cmichailidis/Guitar-Pedal/jlcpcb/production_files/BOM-guitar_pedal.csv

Comment | Designator | Footprint | LCSC | Quantity
4.7R | R40 | R_Axial_DIN0207_L6.3mm_D2.5mm_P7.62mm_Horizontal |  | 1
47n | C21 | C_Rect_L7.2mm_W2.5mm_P5.00mm_FKS2_FKP2_MKS2_MKP2 |  | 1
2.2k | R19 | R_Axial_DIN0207_L6.3mm_D2.5mm_P7.62mm_Horizontal |  | 1
470n | C17 | C_Rect_L7.2mm_W3.5mm_P5.00mm_FKS2_FKP2_MKS2_MKP2 |  | 1
100p | C16 | C_Disc_D6.0mm_W2.5mm_P5.00mm |  | 1
470k | R11 | R_Axial_DIN0207_L6.3mm_D2.5mm_P7.62mm_Horizontal |  | 1
470k | R37 | R_Axial_DIN0207_L6.3mm_D2.5mm_P7.62mm_Horizontal |  | 1
2N3904 | Q1 | TO-92_Inline |  | 1
1N4148 | D6 | D_DO-35_SOD27_P7.62mm_Horizontal |  | 1
100n | C6 | C_Rect_L7.2mm_W2.5mm_P5.00mm_FKS2_FKP2_MKS2_MKP2 |  | 1
2.2k | R41 | R_Axial_DIN0207_L6.3mm_D2.5mm_P7.62mm_Horizontal |  | 1
10k | R32 | R_Axial_DIN0207_L6.3mm_D2.5mm_P7.62mm_Horizontal |  | 1
470k | R35 | R_Axial_DIN0207_L6.3mm_D2.5mm_P7.62mm_Horizontal |  | 1
470n | C18 | C_Rect_L7.2mm_W3.5mm_P5.00mm_FKS2_FKP2_MKS2_MKP2 |  | 1
8.2k | R31 | R_Axial_DIN0207_L6.3mm_D2.5mm_P7.62mm_Horizontal |  | 1
2.2k | R43 | R_Axial_DIN0207_L6.3mm_D2.5mm_P7.62mm_Horizontal |  | 1
470n | C11 | C_Rect_L7.2mm_W3.5mm_P5.00mm_FKS2_FKP2_MKS2_MKP2 |  | 1
1M | R6 | R_Axial_DIN0207_L6.3mm_D2.5mm_P7.62mm_Horizontal |  | 1
2N3904 | Q5 | TO-92_Inline |  | 1
1k | R24 | R_Axial_DIN0207_L6.3mm_D2.5mm_P7.62mm_Horizontal |  | 1
Conn_01x02_Pin | J1 | PinHeader_1x02_P2.54mm_Vertical |  | 1
47n | C8 | C_Rect_L7.2mm_W2.5mm_P5.00mm_FKS2_FKP2_MKS2_MKP2 |  | 1
47u | C2 | CP_Radial_D6.3mm_P2.50mm |  | 1
2N3904 | Q3 | TO-92_Inline |  | 1
470k | R23 | R_Axial_DIN0207_L6.3mm_D2.5mm_P7.62mm_Horizontal |  | 1
4.7M | R33 | R_Axial_DIN0207_L6.3mm_D2.5mm_P7.62mm_Horizontal |  | 1
1k | R4 | R_Axial_DIN0207_L6.3mm_D2.5mm_P7.62mm_Horizontal |  | 1
100R | R36 | R_Axial_DIN0207_L6.3mm_D2.5mm_P7.62mm_Horizontal |  | 1
100k | R48 | R_Axial_DIN0207_L6.3mm_D2.5mm_P7.62mm_Horizontal |  | 1
22k | R46 | R_Axial_DIN0207_L6.3mm_D2.5mm_P7.62mm_Horizontal |  | 1
250p | C13 | C_Disc_D6.0mm_W2.5mm_P5.00mm |  | 1
10p | C26 | C_Disc_D6.0mm_W2.5mm_P5.00mm |  | 1
100n | C5 | C_Rect_L7.2mm_W2.5mm_P5.00mm_FKS2_FKP2_MKS2_MKP2 |  | 1
220p | C7 | C_Disc_D6.0mm_W2.5mm_P5.00mm |  | 1
47k | R15 | R_Axial_DIN0207_L6.3mm_D2.5mm_P7.62mm_Horizontal |  | 1
1N4148 | D1 | D_DO-35_SOD27_P7.62mm_Horizontal |  | 1
10k | R38 | R_Axial_DIN0207_L6.3mm_D2.5mm_P7.62mm_Horizontal |  | 1
10k | R25 | R_Axial_DIN0207_L6.3mm_D2.5mm_P7.62mm_Horizontal |  | 1
100k | R49 | R_Axial_DIN0207_L6.3mm_D2.5mm_P7.62mm_Horizontal |  | 1
100k | R16 | R_Axial_DIN0207_L6.3mm_D2.5mm_P7.62mm_Horizontal |  | 1
47n | C12 | C_Rect_L7.2mm_W2.5mm_P5.00mm_FKS2_FKP2_MKS2_MKP2 |  | 1
100k | RV4 | PinHeader_1x03_P2.54mm_Vertical |  | 1
4.7n | C30 | C_Rect_L7.2mm_W2.5mm_P5.00mm_FKS2_FKP2_MKS2_MKP2 |  | 1
470n | C24 | C_Rect_L7.2mm_W3.5mm_P5.00mm_FKS2_FKP2_MKS2_MKP2 |  | 1
100n | C10 | C_Rect_L7.2mm_W2.5mm_P5.00mm_FKS2_FKP2_MKS2_MKP2 |  | 1
10k | R1 | R_Axial_DIN0207_L6.3mm_D2.5mm_P7.62mm_Horizontal |  | 1
10u | C31 | C_Disc_D6.0mm_W2.5mm_P5.00mm |  | 1
LM358 | U4 | DIP-8_W7.62mm |  | 1
1N5819 | D9 | D_DO-41_SOD81_P10.16mm_Horizontal |  | 1
LM358 | U3 | DIP-8_W7.62mm |  | 1
1k | R28 | R_Axial_DIN0207_L6.3mm_D2.5mm_P7.62mm_Horizontal |  | 1
100n | C15 | C_Rect_L7.2mm_W2.5mm_P5.00mm_FKS2_FKP2_MKS2_MKP2 |  | 1
15n | C20 | C_Rect_L7.2mm_W2.5mm_P5.00mm_FKS2_FKP2_MKS2_MKP2 |  | 1
1N4148 | D4 | D_DO-35_SOD27_P7.62mm_Horizontal |  | 1
10k | R2 | R_Axial_DIN0207_L6.3mm_D2.5mm_P7.62mm_Horizontal |  | 1
LM358 | U2 | DIP-8_W7.62mm |  | 1
47n | C28 | C_Rect_L7.2mm_W2.5mm_P5.00mm_FKS2_FKP2_MKS2_MKP2 |  | 1
47k | R34 | R_Axial_DIN0207_L6.3mm_D2.5mm_P7.62mm_Horizontal |  | 1
10k | R27 | R_Axial_DIN0207_L6.3mm_D2.5mm_P7.62mm_Horizontal |  | 1
2.2k | R18 | R_Axial_DIN0207_L6.3mm_D2.5mm_P7.62mm_Horizontal |  | 1
10k | R12 | R_Axial_DIN0207_L6.3mm_D2.5mm_P7.62mm_Horizontal |  | 1
100k | R39 | R_Axial_DIN0207_L6.3mm_D2.5mm_P7.62mm_Horizontal |  | 1
1k | R7 | R_Axial_DIN0207_L6.3mm_D2.5mm_P7.62mm_Horizontal |  | 1
100k | R9 | R_Axial_DIN0207_L6.3mm_D2.5mm_P7.62mm_Horizontal |  | 1
22k | RV2 | PinHeader_1x03_P2.54mm_Vertical |  | 1
100k | RV1 | PinHeader_1x03_P2.54mm_Vertical |  | 1
10k | R29 | R_Axial_DIN0207_L6.3mm_D2.5mm_P7.62mm_Horizontal |  | 1
Conn_01x02_Pin | J3 | PinHeader_1x02_P2.54mm_Vertical |  | 1
4.7u | C27 | CP_Radial_D5.0mm_P2.50mm |  | 1
1N4148 | D8 | D_DO-35_SOD27_P7.62mm_Horizontal |  | 1
10k | R21 | R_Axial_DIN0207_L6.3mm_D2.5mm_P7.62mm_Horizontal |  | 1
470k | R8 | R_Axial_DIN0207_L6.3mm_D2.5mm_P7.62mm_Horizontal |  | 1
LM358 | U1 | DIP-8_W7.62mm |  | 1
10k | R22 | R_Axial_DIN0207_L6.3mm_D2.5mm_P7.62mm_Horizontal |  | 1
470n | C23 | C_Rect_L7.2mm_W3.5mm_P5.00mm_FKS2_FKP2_MKS2_MKP2 |  | 1
100k | RV5 | PinHeader_1x03_P2.54mm_Vertical |  | 1
1N4148 | D5 | D_DO-35_SOD27_P7.62mm_Horizontal |  | 1
56k | R26 | R_Axial_DIN0207_L6.3mm_D2.5mm_P7.62mm_Horizontal |  | 1
100k | R42 | R_Axial_DIN0207_L6.3mm_D2.5mm_P7.62mm_Horizontal |  | 1
10k | R20 | R_Axial_DIN0207_L6.3mm_D2.5mm_P7.62mm_Horizontal |  | 1
4.7k | R17 | R_Axial_DIN0207_L6.3mm_D2.5mm_P7.62mm_Horizontal |  | 1
100n | C25 | C_Rect_L7.2mm_W2.5mm_P5.00mm_FKS2_FKP2_MKS2_MKP2 |  | 1
1N4148 | D3 | D_DO-35_SOD27_P7.62mm_Horizontal |  | 1
Conn_01x02_Pin | J2 | PinHeader_1x02_P2.54mm_Vertical |  | 1
2.2k | R47 | R_Axial_DIN0207_L6.3mm_D2.5mm_P7.62mm_Horizontal |  | 1
100n | C29 | C_Rect_L7.2mm_W2.5mm_P5.00mm_FKS2_FKP2_MKS2_MKP2 |  | 1
100k | RV3 | PinHeader_1x03_P2.54mm_Vertical |  | 1
100k | R10 | R_Axial_DIN0207_L6.3mm_D2.5mm_P7.62mm_Horizontal |  | 1
2N3904 | Q4 | TO-92_Inline |  | 1
LM358 | U5 | DIP-8_W7.62mm |  | 1
2.2k | R45 | R_Axial_DIN0207_L6.3mm_D2.5mm_P7.62mm_Horizontal |  | 1
47n | C9 | C_Rect_L7.2mm_W2.5mm_P5.00mm_FKS2_FKP2_MKS2_MKP2 |  | 1
4.7M | R5 | R_Axial_DIN0207_L6.3mm_D2.5mm_P7.62mm_Horizontal |  | 1
4.7n | C19 | C_Rect_L7.2mm_W2.5mm_P5.00mm_FKS2_FKP2_MKS2_MKP2 |  | 1
47u | C4 | CP_Radial_D6.3mm_P2.50mm |  | 1
22k | R44 | R_Axial_DIN0207_L6.3mm_D2.5mm_P7.62mm_Horizontal |  | 1
47n | C22 | C_Rect_L7.2mm_W2.5mm_P5.00mm_FKS2_FKP2_MKS2_MKP2 |  | 1
47k | R30 | R_Axial_DIN0207_L6.3mm_D2.5mm_P7.62mm_Horizontal |  | 1
68n | C14 | C_Rect_L7.2mm_W2.5mm_P5.00mm_FKS2_FKP2_MKS2_MKP2 |  | 1
1N4148 | D2 | D_DO-35_SOD27_P7.62mm_Horizontal |  | 1
1N4148 | D7 | D_DO-35_SOD27_P7.62mm_Horizontal |  | 1
10R | R3 | R_Axial_DIN0207_L6.3mm_D2.5mm_P7.62mm_Horizontal |  | 1
47u | C1 | CP_Radial_D6.3mm_P2.50mm |  | 1
100k | R14 | R_Axial_DIN0207_L6.3mm_D2.5mm_P7.62mm_Horizontal |  | 1
2N3904 | Q2 | TO-92_Inline |  | 1
100n | C3 | C_Rect_L7.2mm_W2.5mm_P5.00mm_FKS2_FKP2_MKS2_MKP2 |  | 1
22R | R13 | R_Axial_DIN0207_L6.3mm_D2.5mm_P7.62mm_Horizontal |  | 1
LED | LED3 | PinHeader_1x02_P2.54mm_Vertical |  | 1
Conn_01x02_Pin | J4 | PinHeader_1x02_P2.54mm_Vertical |  | 1
LED | LED1 | PinHeader_1x02_P2.54mm_Vertical |  | 1
LED | LED2 | PinHeader_1x02_P2.54mm_Vertical |  | 1
