cmichailidis/Guitar-Pedal/guitar_pedal.csv

????? | ???????? | ???? | ?????????
C1,C2,C4 | 5 | 47u | ???????? ?????????????? (??????????? 16V)
C3,C5,C6,C10,C15,C25,C29 | 10 | 100n | ???????? ?????????? (???)
C7 | 5 | 220p | ???????? ????????? (??????)
C8,C9,C12,C21,C22,C28 | 10 | 47n | ???????? ?????????? (???)
C11,C17,C18,C23,C24 | 10 | 470n | ???????? ?????????? (???)
C13 | 5 | 250p | ???????? ????????? (??????)
C14 | 5 | 68n | ???????? ?????????? (???)
C16 | 5 | 100p | ???????? ????????? (??????)
C19,C30 | 5 | 4.7n | ???????? ?????????? (???)
C20 | 5 | 15n | ???????? ?????????? (???)
C26 | 5 | 10p | ???????? ????????? (??????)
C27 | 5 | 4.7u | ???????? ?????????????? (??????????? 16V)
C31 | 5 | 10u | ???????? ?????????????? (??????????? 16V)
D1,D2,D3,D4,D5,D6,D7,D8 | 10 | 1N4148 | ??????
D9 | 5 | 1N5819 | ?????? Shottky
Q1,Q2,Q3,Q4,Q5 | 10 | 2N3904 | ?????????? ????????
R1,R2,R12,R20,R21,R22,R25,R27,R29,R32 | 10 | 10k | ????????? 1/4Watt
R3 | 10 | 10R | ????????? 1/4Watt
R4,R7,R24,R28,R38 | 10 | 1k | ????????? 1/4Watt
R5,R33 | 10 | 4.7M | ????????? 1/4Watt
R6 | 10 | 1M | ????????? 1/4Watt
R8,R11,R23,R37 | 10 | 470k | ????????? 1/4Watt
R9,R10,R14,R16,R39,R42,R48,R49 | 10 | 100k | ????????? 1/4Watt
R13 | 10 | 22R | ????????? 1/4Watt
R15,R30,R35 | 10 | 47k | ????????? 1/4Watt
R17,R34 | 10 | 4.7k | ????????? 1/4Watt
R18,R19,R41,R43,R45,R47 | 10 | 2.2k | ????????? 1/4Watt
R26 | 10 | 56k | ????????? 1/4Watt
R31 | 10 | 8.2k | ????????? 1/4Watt
R36 | 10 | 100R | ????????? 1/4Watt
R40 | 10 | 4.7R | ????????? 1/4Watt
R44,R46 | 10 | 22k | ????????? 1/4Watt
U1,U2,U3,U4,U5,U6 | 10 | LM358 | ?????????? ????????? (???????????? ??????? ?? ?????? DIP8)
