cmichailidis/Guitar-Pedal/guitar_pedal.pdf

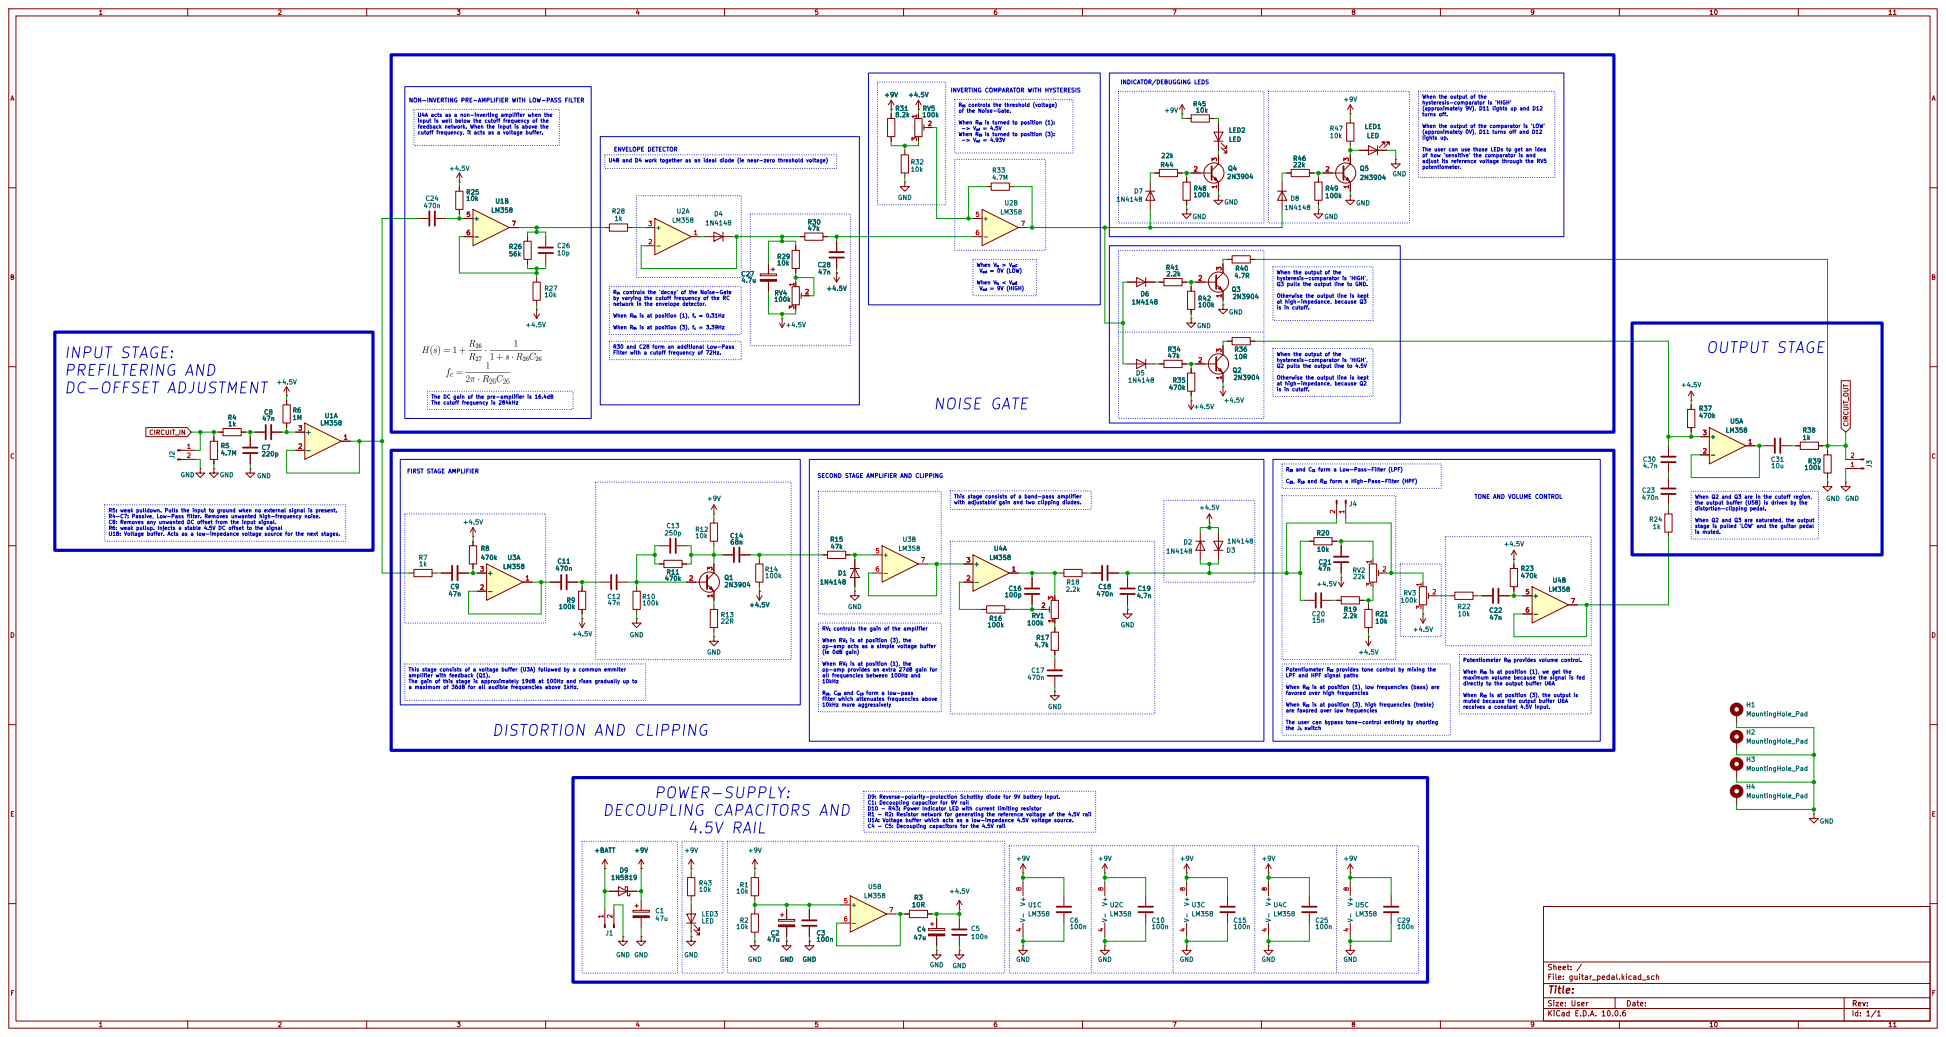
[picture p1: page 1]

INVERTING COMPARATOR WITH HYSTERESIS POWER-SUPPLY:

NON-INVERTING PRE-AMPLIFIER WITH LOW-PASS FILTER U1B

U4A acts as a non-inverting amplifier when the
input is well below the cutoff frequency of the
feedback network. When the input is above the

turns off. When the output of the comparator is 'LOW' (approximately 0V), D11 turns off and D12

lights up. The user can use those LEDs to get an idea

of how 'sensitive' the comparator is and
adjust its reference voltage through the RV5
potentiometer.

INPUT STAGE: PREFILTERING AND

The cutoff frequency is 284kHz

D9: Reverse-polarity-protection Schottky diode for 9V battery input. C1: Decoupling capacitor for 9V rail D10 - R43: Power Indicator LED with current limiting resistor R1 - R2: Resistor network for generating the reference voltage of the 4.5V rail U1A: Voltage buffer which acts as a low-impedance 4.5V voltage source. C4 - C5: Decoupling capacitors for the 4.5V rail NOISE GATE

is muted. R20 and C21 form a Low-Pass-Filter (LPF) C20, R19 and R21 form a High-Pass-Filter (HPF) RV1 controls the gain of the amplifier When RV1 is at position (3), the op-amp acts as a simple voltage buffer (ie 0dB gain) When RV1 is at position (1), the op-amp provides an extra 27dB gain for all frequencies between 100Hz and 10kHz R18, C18 and C19 form a low-pass
SECOND STAGE AMPLIFIER AND CLIPPING

TONE AND VOLUME CONTROL

This stage consists of a voltage buffer (U3A) followed by a common emmiter amplifier with feedback (Q1). The gain of this stage is approximately 19dB at 100Hz and rises gradually up to

LPF and HPF signal paths When RV2 is at position (1), low frequencies (bass) are

directly to the output buffer U6A When RV3 is at position (3), the output is muted because the output buffer U6A

favored over high frequencies When RV2 is at position (3), high frequencies (treble) are favored over low frequencies

filter which attenuates frequencies above 10kHz more aggressively

The user can bypass tone-control entirely by shorting
the J4 switch

Size: User | Rev:
KiCad E.D.A. 10.0.6 | Id: 1/1
