cmichailidis/Guitar-Pedal/guitar_pedal.kicad_pcb

## KiCad design guitar_pedal.kicad_pcb (2026-10-21)

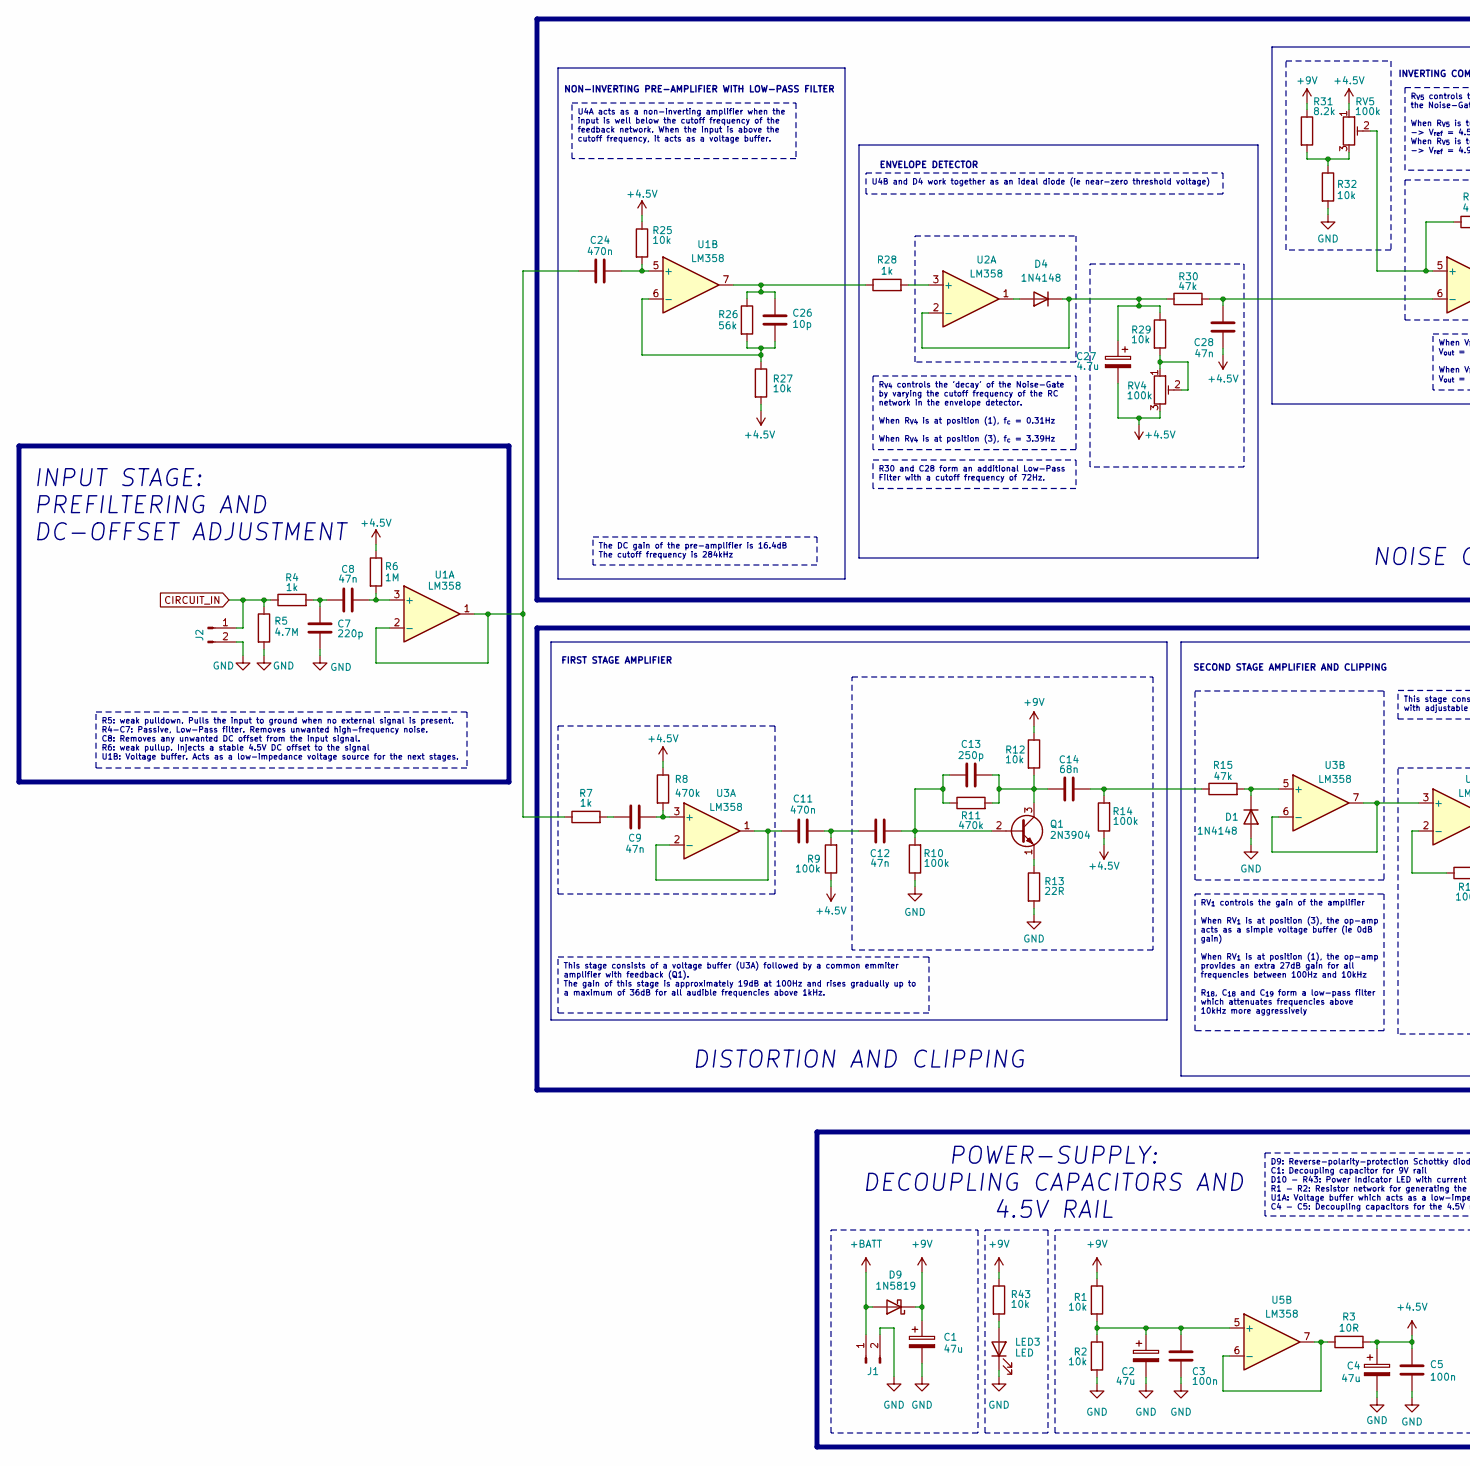
[picture p2: schematic guitar_pedal.kicad_sch, part in row 1, column 1]

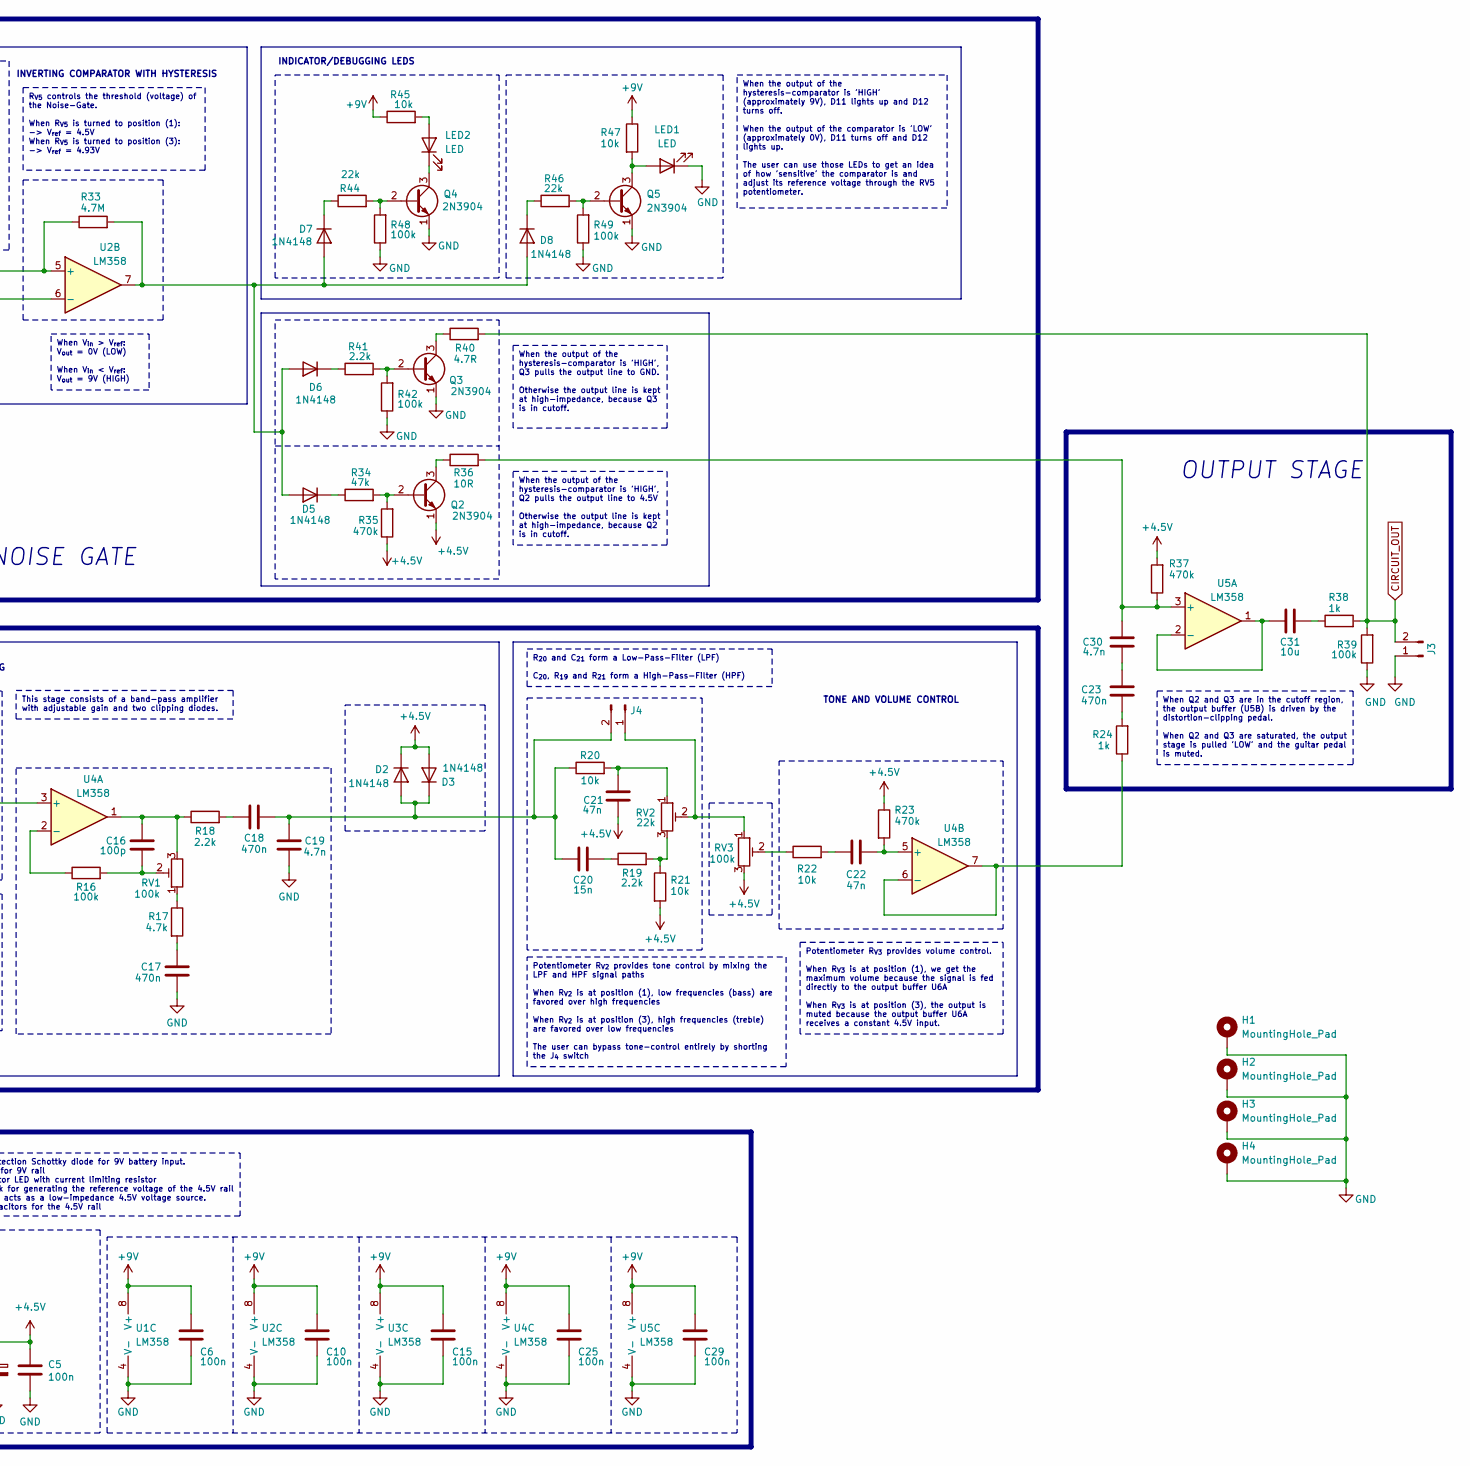
[picture p3: schematic guitar_pedal.kicad_sch, part in row 1, column 2]

Parts:
C1, C2, C4: 47u; CP_Radial_D6.3mm_P2.50mm
C3, C5, C6, C10, C15, C25, C29: 100n; C_Rect_L7.2mm_W2.5mm_P5.00mm_FKS2_FKP2_MKS2_MKP2
C7: 220p; C_Disc_D6.0mm_W2.5mm_P5.00mm
C8, C9, C12, C21, C22, C28: 47n; C_Rect_L7.2mm_W2.5mm_P5.00mm_FKS2_FKP2_MKS2_MKP2
C11, C17, C18, C23, C24: 470n; C_Rect_L7.2mm_W3.5mm_P5.00mm_FKS2_FKP2_MKS2_MKP2
C13: 250p; C_Disc_D6.0mm_W2.5mm_P5.00mm
C14: 68n; C_Rect_L7.2mm_W2.5mm_P5.00mm_FKS2_FKP2_MKS2_MKP2
C16: 100p; C_Disc_D6.0mm_W2.5mm_P5.00mm
C19, C30: 4.7n; C_Rect_L7.2mm_W2.5mm_P5.00mm_FKS2_FKP2_MKS2_MKP2
C20: 15n; C_Rect_L7.2mm_W2.5mm_P5.00mm_FKS2_FKP2_MKS2_MKP2
C26: 10p; C_Disc_D6.0mm_W2.5mm_P5.00mm
C27: 4.7u; CP_Radial_D5.0mm_P2.50mm
C31: 10u; C_Disc_D6.0mm_W2.5mm_P5.00mm
D1, D2, D3, D4, D5, D6, D7, D8: 1N4148; D_DO-35_SOD27_P7.62mm_Horizontal
D9: 1N5819; D_DO-41_SOD81_P10.16mm_Horizontal
H1, H2, H3, H4: MountingHole_Pad; MountingHole_3.2mm_M3_DIN965_Pad
J1, J2, J3, J4: Conn_01x02_Pin; PinHeader_1x02_P2.54mm_Vertical
LED1, LED2, LED3: LED; PinHeader_1x02_P2.54mm_Vertical
Q1, Q2, Q3, Q4, Q5: 2N3904; TO-92_Inline
R1, R2, R12, R20, R21, R22, R25, R27, R29, R32, R43, R45, R47: 10k; R_Axial_DIN0207_L6.3mm_D2.5mm_P7.62mm_Horizontal
R3, R36: 10R; R_Axial_DIN0207_L6.3mm_D2.5mm_P7.62mm_Horizontal
R4, R7, R24, R28, R38: 1k; R_Axial_DIN0207_L6.3mm_D2.5mm_P7.62mm_Horizontal
R5, R33: 4.7M; R_Axial_DIN0207_L6.3mm_D2.5mm_P7.62mm_Horizontal
R6: 1M; R_Axial_DIN0207_L6.3mm_D2.5mm_P7.62mm_Horizontal
R8, R11, R23, R35, R37: 470k; R_Axial_DIN0207_L6.3mm_D2.5mm_P7.62mm_Horizontal
R9, R10, R14, R16, R39, R42, R48, R49: 100k; R_Axial_DIN0207_L6.3mm_D2.5mm_P7.62mm_Horizontal
R13: 22R; R_Axial_DIN0207_L6.3mm_D2.5mm_P7.62mm_Horizontal
R15, R30, R34: 47k; R_Axial_DIN0207_L6.3mm_D2.5mm_P7.62mm_Horizontal
R17: 4.7k; R_Axial_DIN0207_L6.3mm_D2.5mm_P7.62mm_Horizontal
R18, R19, R41: 2.2k; R_Axial_DIN0207_L6.3mm_D2.5mm_P7.62mm_Horizontal
R26: 56k; R_Axial_DIN0207_L6.3mm_D2.5mm_P7.62mm_Horizontal
R31: 8.2k; R_Axial_DIN0207_L6.3mm_D2.5mm_P7.62mm_Horizontal
R40: 4.7R; R_Axial_DIN0207_L6.3mm_D2.5mm_P7.62mm_Horizontal
R44, R46: 22k; R_Axial_DIN0207_L6.3mm_D2.5mm_P7.62mm_Horizontal
RV1, RV3, RV4, RV5: 100k; PinHeader_1x03_P2.54mm_Vertical
RV2: 22k; PinHeader_1x03_P2.54mm_Vertical
U1, U2, U3, U4, U5: LM358; DIP-8_W7.62mm

Connections:
+4.5V: C4.1, C5.2, C21.1, C27.2, C28.1, D2.1 (K), D3.2 (A), Q2.1 (E), R3.2, R6.1, R8.1, R9.1, R14.1, R21.2, R23.1, R25.1, R27.2, R35.1, R37.2, RV3.3, RV4.3, RV5.1
+9V: C1.1, C6.2, C10.2, C15.2, C25.2, C29.2, D9.1 (K), R1.1, R12.1, R31.1, R43.1, R45.1, R47.1, U1.8 (V+), U2.8 (V+), U3.8 (V+), U4.8 (V+), U5.8 (V+)
+BATT: D9.2 (A), J1.1
CIRCUIT_IN: J2.1, R4.1, R5.1
CIRCUIT_OUT: J3.2, R38.2, R39.2, R40.2
GND: C1.2, C2.2, C3.1, C4.2, C5.1, C6.1, C7.1, C10.1, C15.1, C17.1, C19.1, C25.1, C29.1, D1.2 (A), H1.1 (1_1), H2.1 (1_1), H3.1 (1_1), H4.1 (1_1), J1.2, J2.2, J3.1, LED1.1 (K), LED3.1 (K), Q3.1 (E), Q4.1 (E), Q5.1 (E), R2.2, R5.2, R10.1, R13.2, R32.2, R39.1, R42.1, R48.1, R49.1, U1.4 (V-), U2.4 (V-), U3.4 (V-), U4.4 (V-), U5.4 (V-)
unnamed: C7.2, C8.1, R4.2
unnamed: C9.1, R7.2
unnamed: C11.2, C12.2, R9.2
unnamed: C14.2, R14.2, R15.1
unnamed: C16.1, R16.2, RV1.2
unnamed: C16.2, R18.1, RV1.3, U4.1
unnamed: C17.2, R17.2
unnamed: C18.1, R18.2
unnamed: C20.2, R19.1
unnamed: C21.2, R20.2, RV2.1
unnamed: C22.1, R22.2
unnamed: C23.1, R24.2
unnamed: C23.2, C30.1
unnamed: C26.2, R26.1, R28.1, U1.7
unnamed: C31.2, R38.1
unnamed: D1.1 (K), R15.2, U3.5 (+)
unnamed: C18.2, C19.2, C20.1, D2.2 (A), D3.1 (K), J4.2, R20.1
unnamed: D4.2 (A), U2.1
unnamed: C27.1, D4.1 (K), R29.1, R30.1, U2.2 (-)
unnamed: D5.2 (A), D6.2 (A), D7.2 (A), D8.2 (A), R33.2, U2.7
unnamed: D5.1 (K), R34.1
unnamed: D6.1 (K), R41.1
unnamed: D7.1 (K), R44.1
unnamed: D8.1 (K), R46.1
unnamed: J4.1, RV2.2, RV3.1
unnamed: LED1.2 (A), Q5.3 (C), R47.2
unnamed: LED2.2 (A), R45.2
unnamed: LED2.1 (K), Q4.3 (C)
unnamed: LED3.2 (A), R43.2
unnamed: C12.1, C13.1, Q1.2 (B), R10.2, R11.1
unnamed: C13.2, C14.1, Q1.3 (C), R11.2, R12.2
unnamed: Q1.1 (E), R13.1
unnamed: Q2.2 (B), R34.2, R35.2
unnamed: Q2.3 (C), R36.1
unnamed: Q3.2 (B), R41.2, R42.2
unnamed: Q3.3 (C), R40.1
unnamed: Q4.2 (B), R44.2, R48.2
unnamed: Q5.2 (B), R46.2, R49.2
unnamed: R17.1, RV1.1
unnamed: R19.2, R21.1, RV2.3
unnamed: R22.1, RV3.2
unnamed: R29.2, RV4.1, RV4.2
unnamed: R31.2, R32.1, RV5.3
unnamed: C8.2, R6.2, U1.3 (+)
unnamed: C24.1, R7.1, U1.1, U1.2 (-)
unnamed: C24.2, R25.2, U1.5 (+)
unnamed: C26.1, R26.2, R27.1, U1.6 (-)
unnamed: R28.2, U2.3 (+)
unnamed: R33.1, RV5.2, U2.5 (+)
unnamed: C28.2, R30.2, U2.6 (-)
unnamed: C9.2, R8.2, U3.3 (+)
unnamed: C11.1, U3.1, U3.2 (-)
unnamed: U3.6 (-), U3.7, U4.3 (+)
unnamed: R16.1, U4.2 (-)
unnamed: C22.2, R23.2, U4.5 (+)
unnamed: R24.1, U4.6 (-), U4.7
unnamed: C30.2, R36.2, R37.1, U5.3 (+)
unnamed: C31.1, U5.1, U5.2 (-)
unnamed: C2.1, C3.2, R1.2, R2.1, U5.5 (+)
unnamed: R3.1, U5.6 (-), U5.7

Notes on the sheet:
SECOND STAGE AMPLIFIER AND CLIPPING
POWER-SUPPLY: DECOUPLING CAPACITORS AND 4.5V RAIL
INPUT STAGE: PREFILTERING AND DC-OFFSET ADJUSTMENT
NON-INVERTING PRE-AMPLIFIER WITH LOW-PASS FILTER
NOISE GATE
INVERTING COMPARATOR WITH HYSTERESIS
ENVELOPE DETECTOR
INDICATOR/DEBUGGING LEDS
DISTORTION AND CLIPPING
TONE AND VOLUME CONTROL
OUTPUT STAGE
FIRST STAGE AMPLIFIER
This stage consists of a voltage buffer (U3A) followed by a common emmiter amplifier with feedback (Q1). The gain of this stage is approximately 19dB at 100Hz and rises gradually up to a maximum of 36dB for all audible frequencies above 1kHz.
D9: Reverse-polarity-protection Schottky diode for 9V battery input. C1: Decoupling capacitor for 9V rail D10 - R43: Power Indicator LED with current limiting resistor R1 - R2: Resistor network for generating the reference voltage of the 4.5V rail U1A: Voltage buffer which acts as a low-impedance 4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
Potentiometer R_{V2} provides tone control by mixing the LPF and HPF signal paths When R_{V2} is at position (1), low frequencies (bass) are favored over high frequencies When R_{V2} is at position (3), high frequencies (treble) are favored over low frequencies The user can bypass tone-control enti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
When V_{in} > V_{ref}: V_{out} = 0V (LOW) When V_{in} < V_{ref}: V_{out} = 9V (HIGH)
The DC gain of the pre-amplifier is 16.4dB The cutoff frequency is 284kHz
RV_{1} controls the gain of the amplifier When RV_{1} is at position (3), the op-amp acts as a simple voltage buffer (ie 0dB gain) When RV_{1} is at position (1), the op-amp provides an extra 27dB gain for all frequencies between 100Hz and 10kHz R_{18}, C_{18} and C_{19} form a low-pass filter whic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
When the output of the hysteresis-comparator is 'HIGH', Q3 pulls the output line to GND. Otherwise the output line is kept at high-impedance, because Q3 is in cutoff.
U4B and D4 work together as an ideal diode (ie near-zero threshold voltage)
R5: weak pulldown. Pulls the input to ground when no external signal is present. R4-C7: Passive, Low-Pass filter. Removes unwanted high-frequency noise. C8: Removes any unwanted DC offset from the input signal. R6: weak pullup. Injects a stable 4.5V DC offset to the signal U1B: Voltage buffer. Acts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
R_{V5} controls the threshold (voltage) of the Noise-Gate. When R_{V5} is turned to position (1): -> V_{ref} = 4.5V When R_{V5} is turned to position (3): -> V_{ref} = 4.93V
When the output of the hysteresis-comparator is 'HIGH' (approximately 9V), D11 lights up and D12 turns off. When the output of the comparator is 'LOW' (approximately 0V), D11 turns off and D12 lights up. The user can use those LEDs to get an idea of how 'sensitive' the comparator is and adjust its 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
This stage consists of a band-pass amplifier with adjustable gain and two clipping diodes.
When the output of the hysteresis-comparator is 'HIGH', Q2 pulls the output line to 4.5V Otherwise the output line is kept at high-impedance, because Q2 is in cutoff.
R30 and C28 form an additional Low-Pass Filter with a cutoff frequency of 72Hz.
R_{20} and C_{21} form a Low-Pass-Filter (LPF) C_{20}, R_{19} and R_{21} form a High-Pass-Filter (HPF)
When Q2 and Q3 are in the cutoff region, the output buffer (U5B) is driven by the distortion-clipping pedal. When Q2 and Q3 are saturated, the output stage is pulled 'LOW' and the guitar pedal is muted.
R_{V4} controls the 'decay' of the Noise-Gate by varying the cutoff frequency of the RC network in the envelope detector. When R_{V4} is at position (1), f_{c} = 0.31Hz When R_{V4} is at position (3), f_{c} = 3.39Hz
Potentiometer R_{V3} provides volume control. When R_{V3} is at position (1), we get the maximum volume because the signal is fed directly to the output buffer U6A When R_{V3} is at position (3), the output is muted because the output buffer U6A receives a constant 4.5V input.
U4A acts as a non-inverting amplifier when the input is well below the cutoff frequency of the feedback network. When the input is above the cutoff frequency, it acts as a voltage buffer.

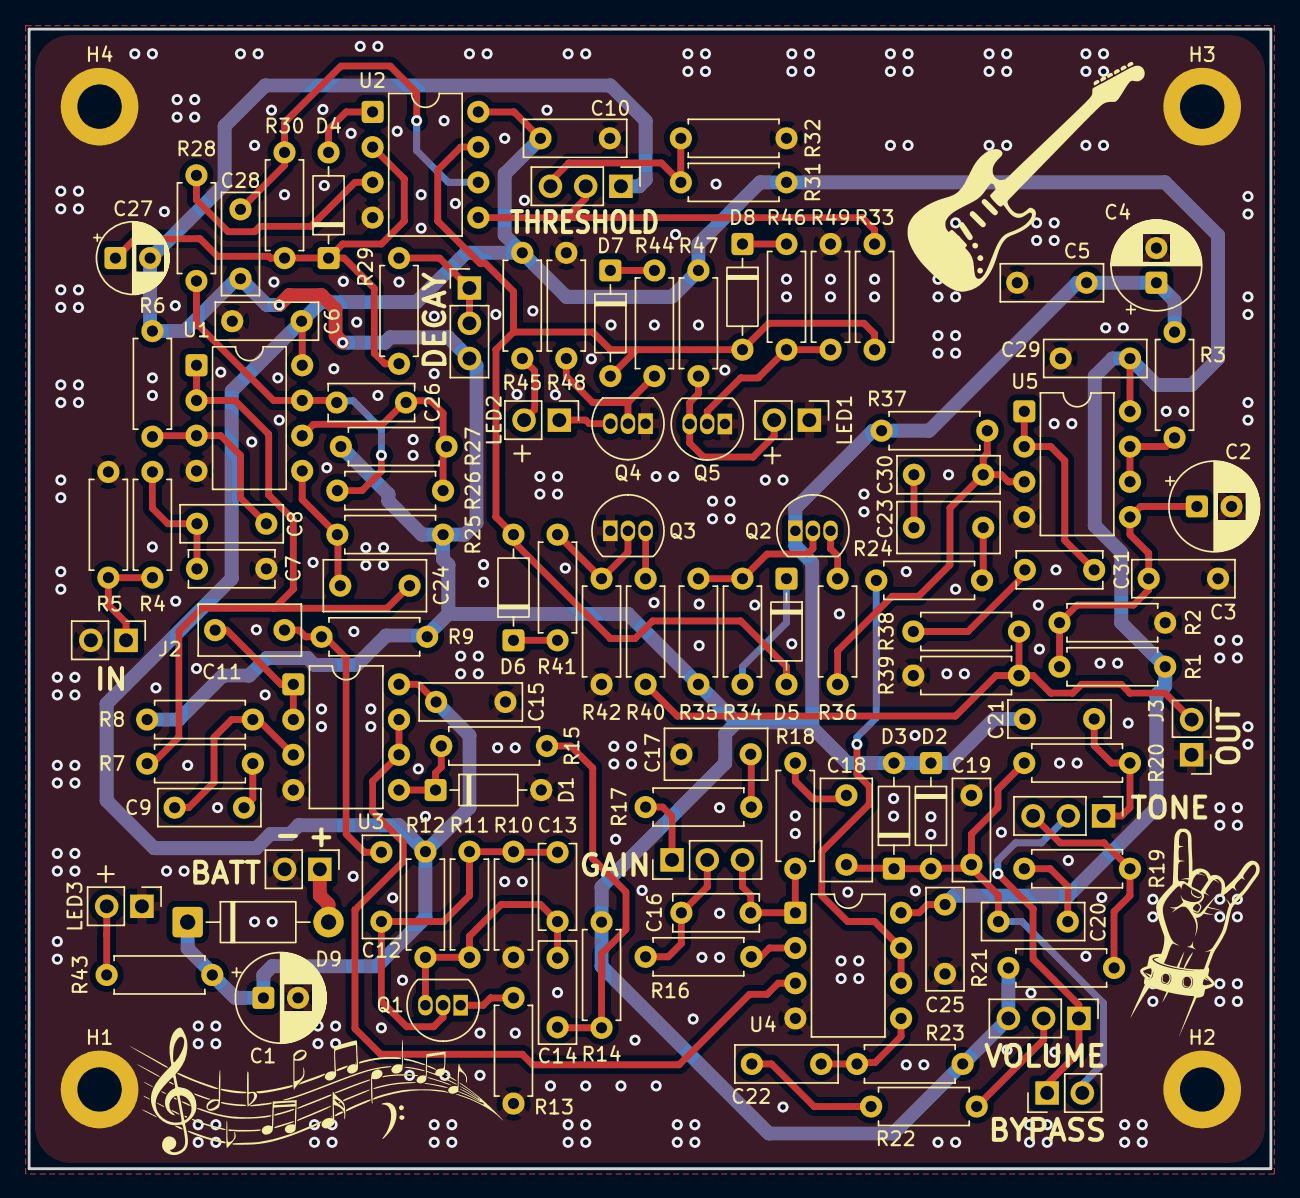
[picture p4: board guitar_pedal.kicad_pcb from above]

Board: 2 copper layers, 89.5 x 82.2 mm, 115 parts (0 on the bottom side), 66 nets.
