cmichailidis/Guitar-Pedal/(commit log)

2026-08-31 Fixed minor issues with PCB mounting holes
    [BOM-guitar_pedal.csv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]
2026-08-31 fixed issues with duplicate files and reorganized file structure of the repository
    [BOM-guitar_pedal.csv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]
2026-09-04 minor updates in exported PDF schematic
2026-09-06 replaced ceramic capacitors with polyester. Added stitching vias between top and bottom ground planes
    [guitar_pedal.kicad_pcb, guitar_pedal.kicad_sch]
2026-09-14 added a gitignore file to remove temporary KiCAD files from git pipeline
2026-09-14 added new production files with improved PCB layout
    [BOM-guitar_pedal.csv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]
2026-09-14 drop files from .gitignore
    [guitar_pedal.kicad_pcb, guitar_pedal.kicad_sch]
2026-10-21 fixed pull-downn lines for noise gate
    [guitar_pedal.kicad_sch]
2026-10-21 updated exported pdf with proper noise gate schematic
